prosper00/STM8-AD9833-Function-Generator/doc/SPL/resc/library_files_inclusion.bmp

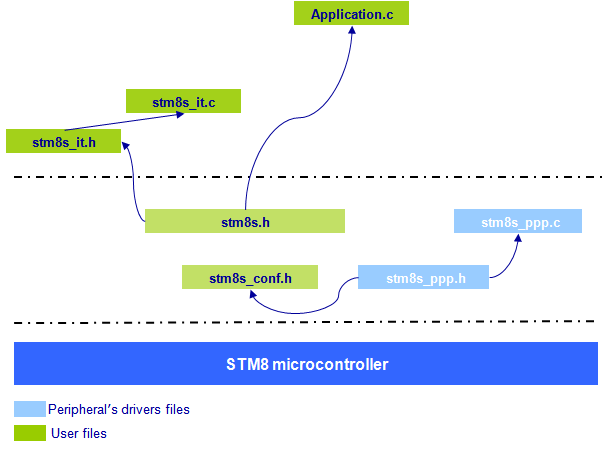
doc/SPL/resc/library_files_inclusion.bmp
