prosper00/STM8-AD9833-Function-Generator/doc/SPL/resc/library_folder_structure.bmp

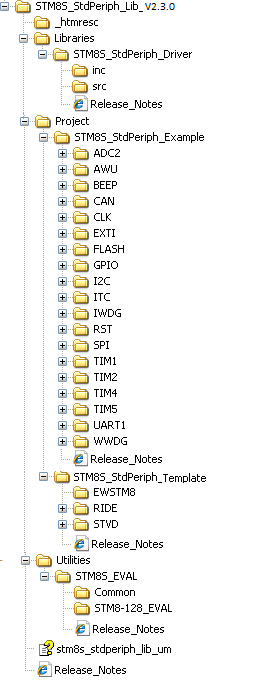
doc/SPL/resc/library_folder_structure.bmp
