prosper00/STM8-AD9833-Function-Generator/doc/SPL/resc/stm8_devices.bmp

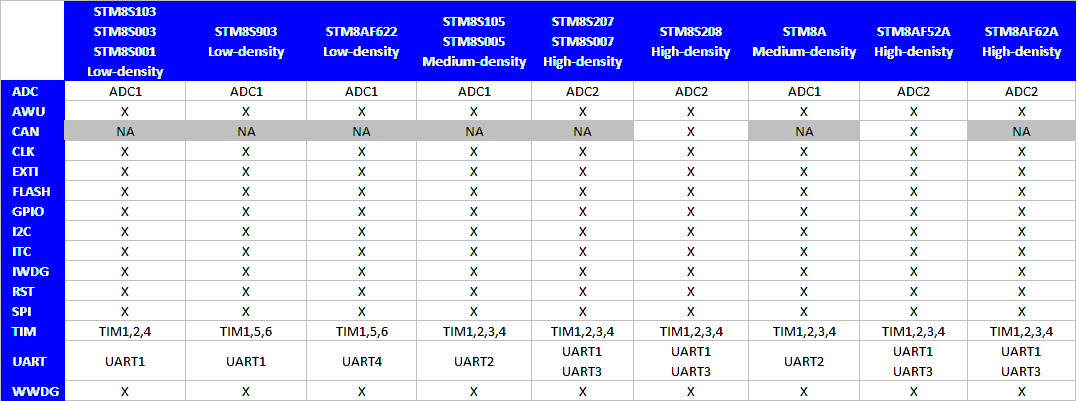
doc/SPL/resc/stm8_devices.bmp
