prosper00/STM8-AD9833-Function-Generator/doc/SPL/resc/stm8s.bmp

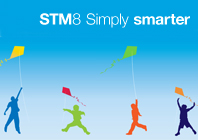
doc/SPL/resc/stm8s.bmp
