prosper00/STM8-AD9833-Function-Generator/doc/SPL/resc/stm8s_archi.bmp

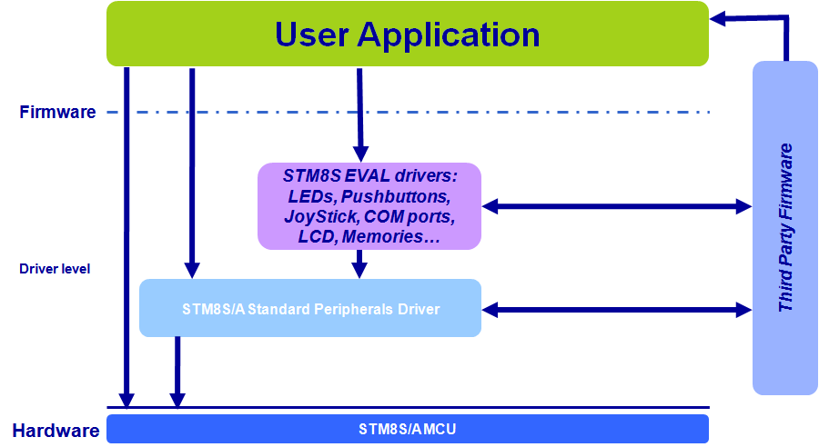
doc/SPL/resc/stm8s_archi.bmp
