prosper00/STM8-AD9833-Function-Generator/doc/Function Generator/Function Generator.pdf

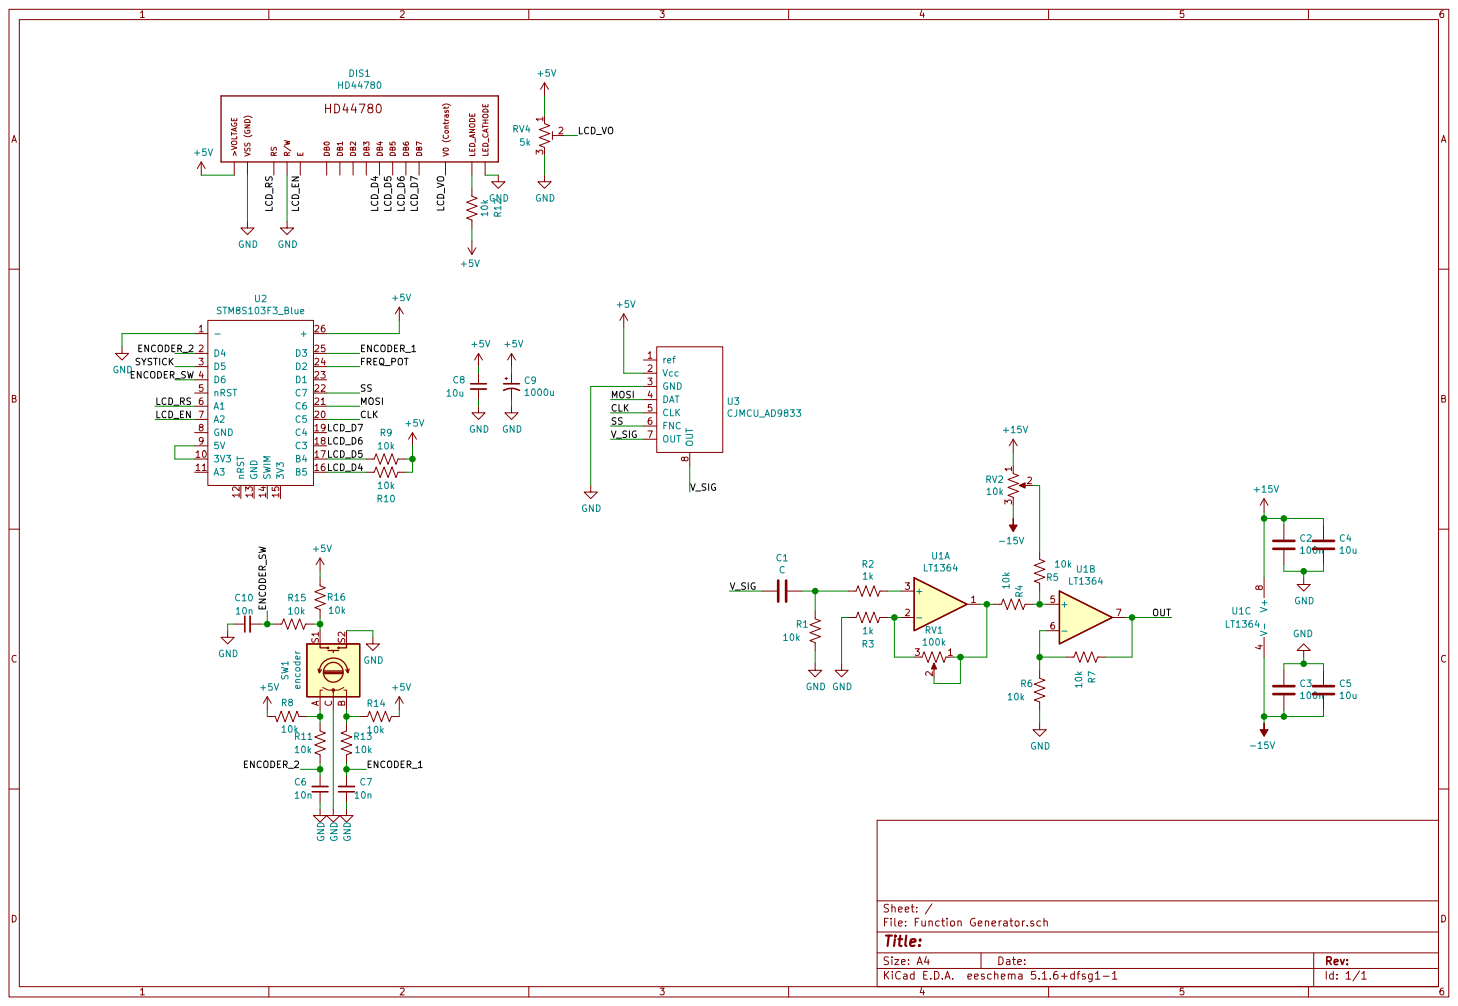
[picture p11: page 1]

8 U3CJMCU_AD9833 >VOLTAGE VSS (GND) RSR/W EDB0 DB1 DB2 DB3 DB4 DB5 DB6 DB7 V0 (Contrast) LED_ANODE LED_CATHODEHD44780

Id: 1/1 Title: File: Function Generator.sch Sheet: /
