prosper00/STM8-AD9833-Function-Generator/debounce.kicad_sch

## KiCad design debounce.kicad_sch (2024-02-06)

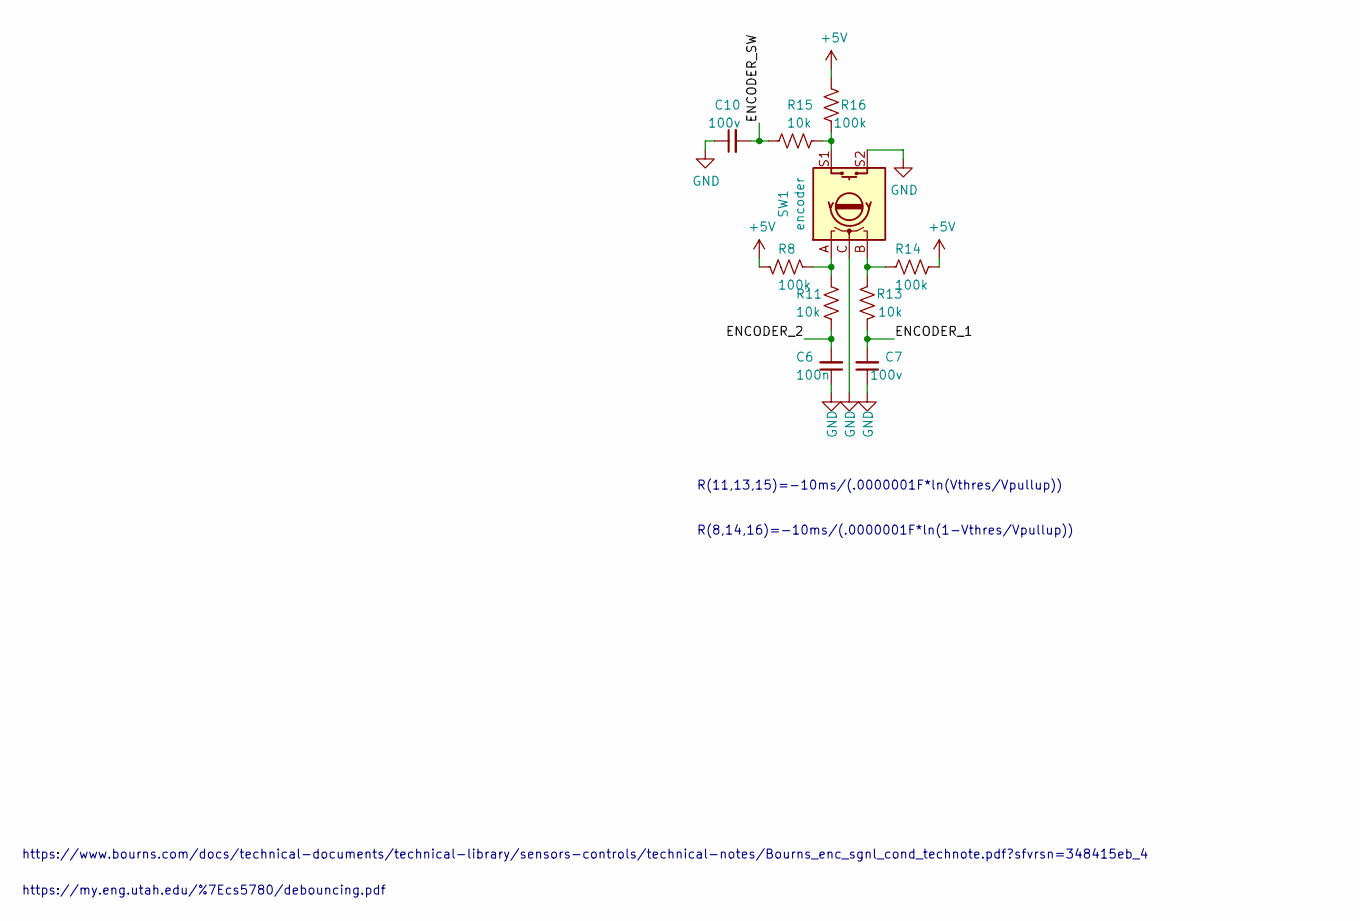
[picture p12: schematic debounce.kicad_sch]

Parts:
C6: 100n
C7, C10: 100v
R8, R14, R16: 100k
R11, R13, R15: 10k
SW1: encoder

Connections:
+5V: R8.2, R14.1, R16.2
ENCODER_1: C7.2, R13.2
ENCODER_2: C6.2, R11.2
ENCODER_SW: C10.2, R15.2
GND: C6.1, C7.1, C10.1, SW1.C, SW1.S2
unnamed: R8.1, R11.1, SW1.A
unnamed: R13.1, R14.2, SW1.B
unnamed: R15.1, R16.1, SW1.S1

Notes on the sheet:
https://www.bourns.com/docs/technical-documents/technical-library/sensors-controls/technical-notes/Bourns_enc_sgnl_cond_technote.pdf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
R(11,13,15)=-10ms/(.0000001F*ln(Vthres/Vpullup))
https://my.eng.utah.edu/%7Ecs5780/debouncing.pdf
R(8,14,16)=-10ms/(.0000001F*ln(1-Vthres/Vpullup))
