prosper00/STM8-AD9833-Function-Generator/doc/Function Generator/Function Generator.sch

## KiCad design doc/Function Generator/Function Generator.sch (2021-05-05)

Schematic: Function Generator.sch

Parts:
C1: C
C2, C3: 100n
C4, C5, C8: 10u
C6, C7, C10: 10n
C9: 1000u
DIS1: HD44780; 16026-16X2; VOLTAGE 5V
R1, R4, R5, R6, R7, R8, R9, R10, R11, R12, R13, R14, R15, R16: 10k
R2, R3: 1k
RV1: 100k
RV2: 10k
RV4: 5k
SW1: encoder
U1: LT1364
U2: STM8S103F3_Blue
U3: CJMCU_AD9833

Notes on the sheet:
https://www.bourns.com/docs/technical-documents/technical-library/sensors-controls/technical-notes/Bourns_enc_sgnl_cond_technote.pdf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
