prosper00/STM8-AD9833-Function-Generator/(commit log)

2020-11-27 added a TIM4-based interrupt-driven tick, and delay function
2020-12-04 Fixed bug setting SQUARE waveshape
    [AD9833.c, AD9833.h, main.c]
2020-12-07 ADC logic - log response, oversampling
2020-12-10 refactor delay.c: provide delay_us(), millis() and micros()
2021-01-14 SPI is broken. Troubleshooting...
    [main.c]
2021-01-14 Fixed SPI. Changed SPI SS to C7 (from A3), so that I can use A3 as PWM output (not yet implemented)
    [AD9833.c, main.c, main.h]
2021-01-22 adding schematics
    [FuncGen.sch]
2021-01-25 added kicad dwgs
    [FuncGen.sch, Function Generator.sch]
2021-01-25 Kicad drawings
    [Function Generator.sch]
2021-04-26 Updates to readme - got opamp circuit implemented
2021-04-26 Updates to documentation regarding opamp offset/amplitude circuit
2021-04-26 tweaks to schematics
    [Function Generator.sch]
2021-04-26 Exported schematic to PDF
2021-04-30 creating 'dev' branch
    [STM8-pinouts.ods]
2021-05-02 preliminary rotary encoder support. Compiles. Not tested.
    [STM8-pinouts.ods]
2021-05-02 added rotary encoder to schematic
    [Function Generator.sch]
2021-05-03 Working, but velocity scaling needs polish
    [Function Generator.sch]
2021-05-05 implemented rotary encoder hardware debounce, and read inputs in an ISR
    [Function Generator.sch]
2021-05-06 Added acceleration to rotary encoder input. Preliminary work on EEPROM support to save current settings
2021-05-06 Update README.md
    added pin assignment table
2024-01-25 Minor changes to remove SDCC >=4.3.0 warnings/errors Compiles, but not tested.
    [TIM1PWM.c, TIM1PWM.h, delay.c, eeprom.h, main.c, main.h]
2024-02-06 Makefile fixes for recent SDCC version
    [debounce.kicad_sch]
